Hallel133/Hallel133/docs/img/chair-front.png

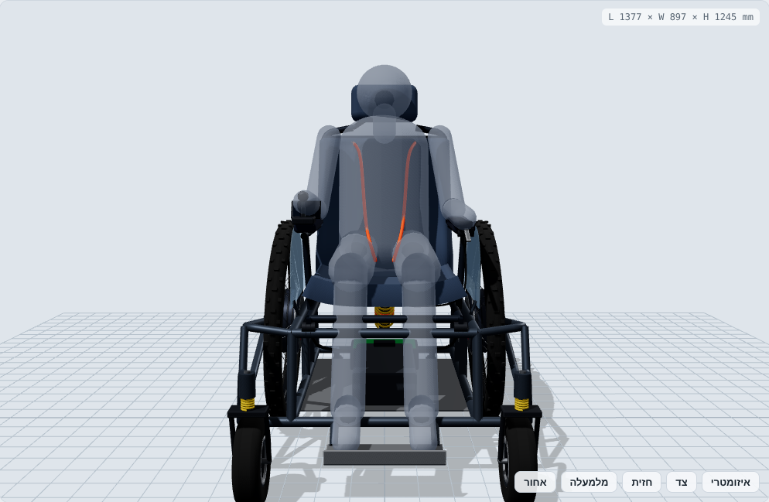
docs/img/chair-front.png
