Hallel133/Hallel133/docs/img/chair-rear.png

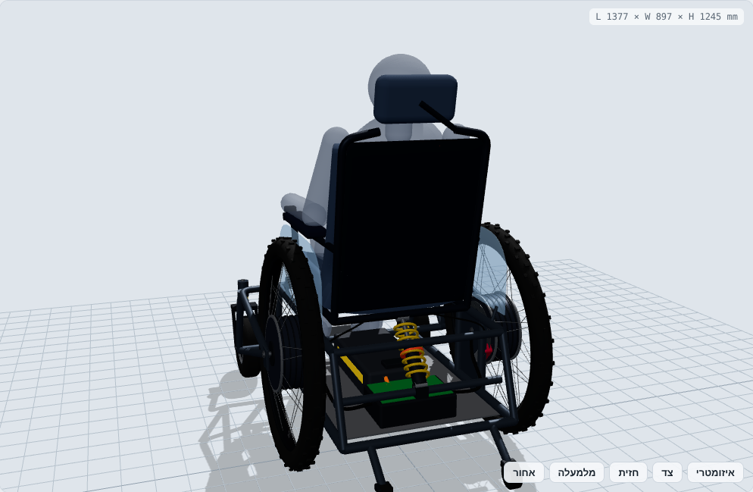
docs/img/chair-rear.png
