Hallel133/Hallel133/docs/img/chair-side.png

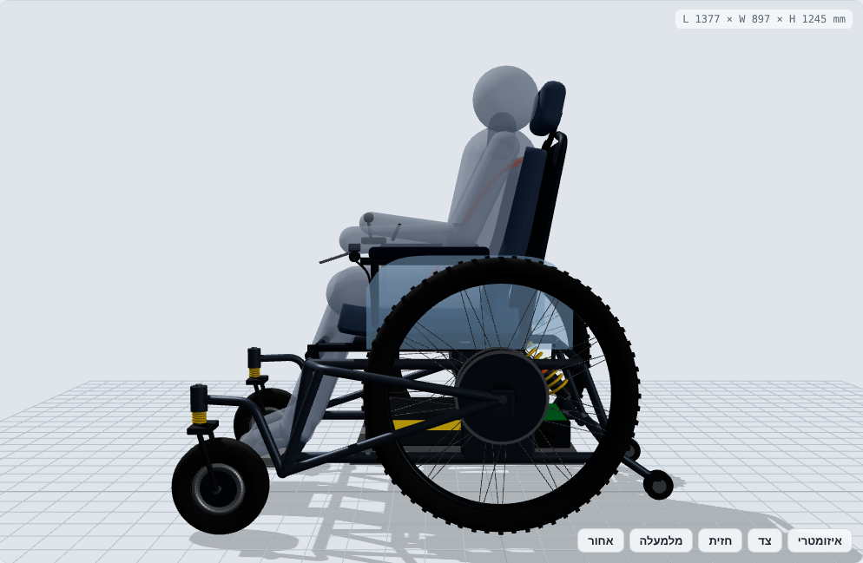
docs/img/chair-side.png
