Hallel133/Hallel133/docs/img/kart-front.png

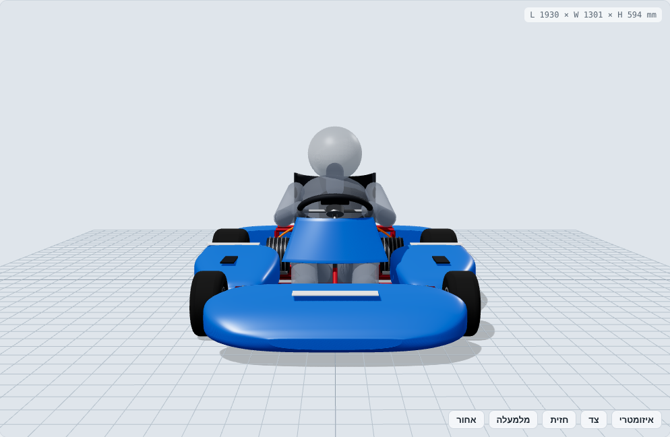
docs/img/kart-front.png
