Hallel133/Hallel133/docs/img/kart-side.png

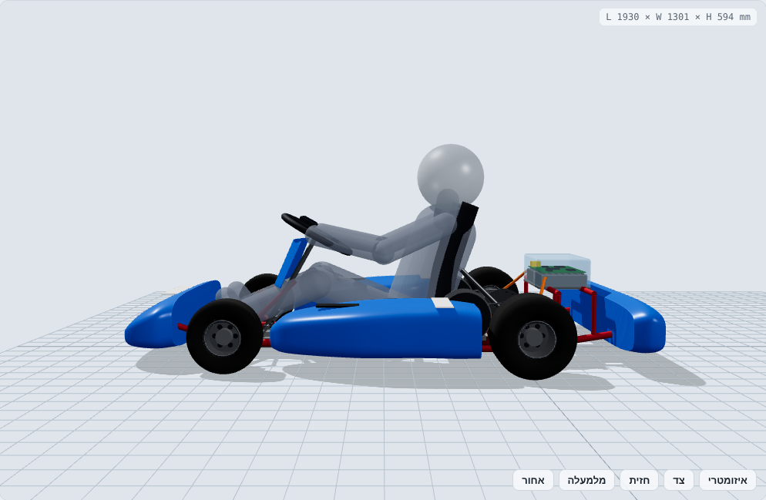
docs/img/kart-side.png
