Hallel133/Hallel133/docs/img/kart-top.png

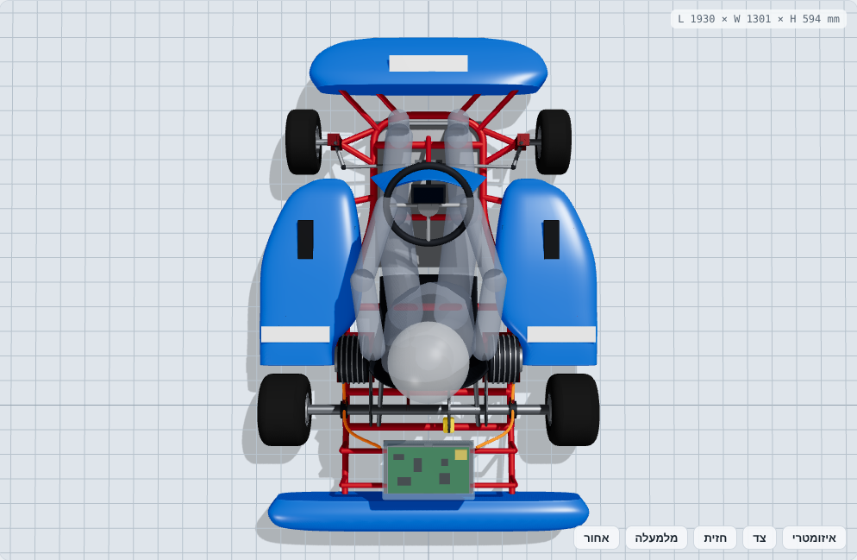
docs/img/kart-top.png
