Hallel133/Hallel133/exports/gokart/chassis.stl

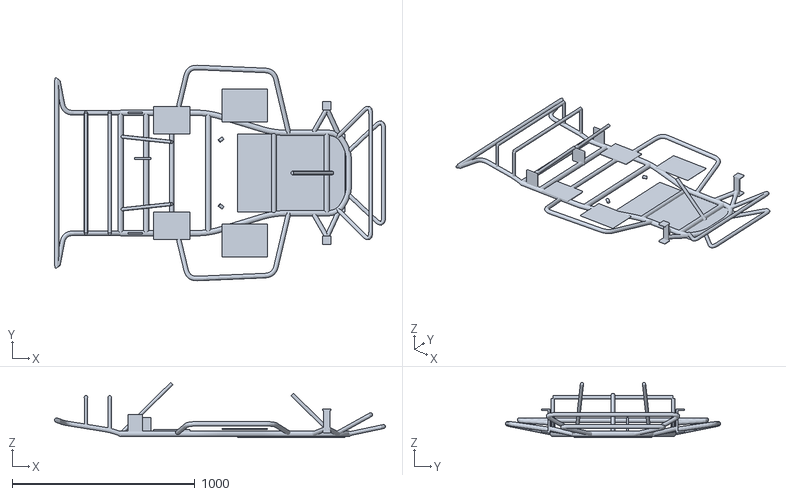
[picture p11: CAD file, 2026-10-14]
exports/gokart/chassis.stl
1813.4 x 1180.7 x 301.4
