Hallel133/Hallel133/exports/wheelchair/seat.stl

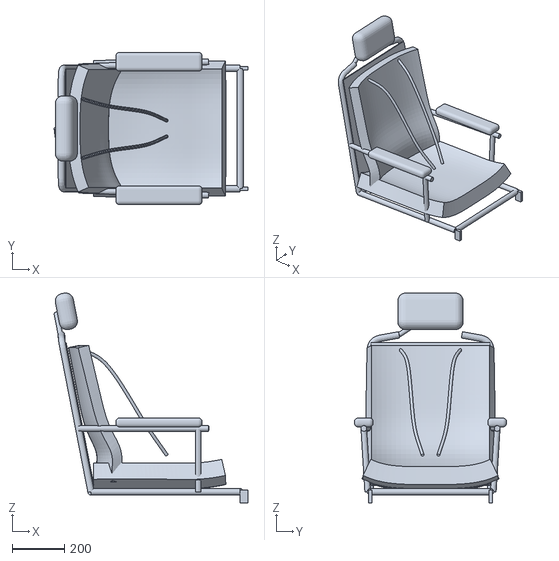
[picture p12: CAD file, 2026-10-14]
exports/wheelchair/seat.stl
741.1 x 582.0 x 803.0
