Hallel133/Hallel133/exports/gokart/battery.stl

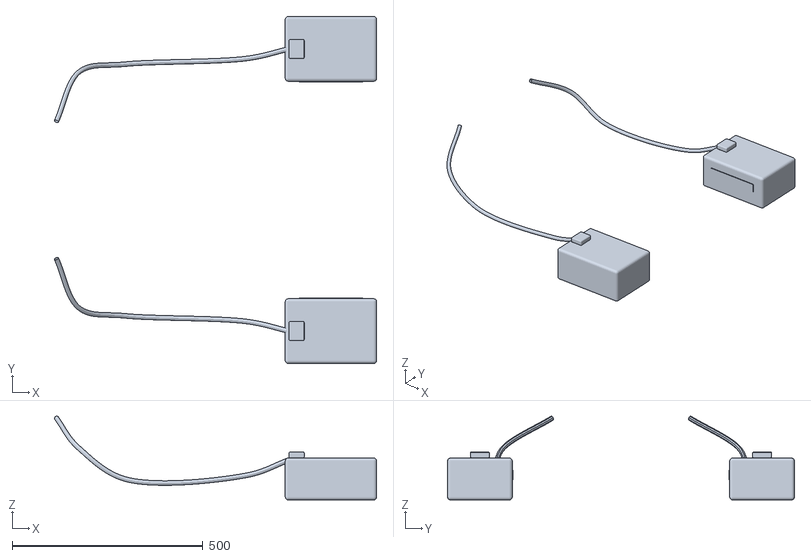
[picture p13: CAD file, 2026-10-14]
exports/gokart/battery.stl
845.6 x 910.0 x 220.1
