Hallel133/Hallel133/exports/wheelchair/frame.stl

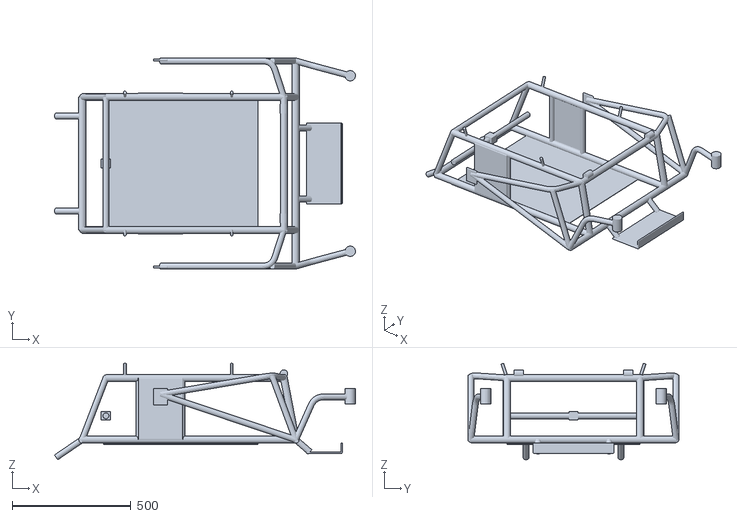
[picture p14: CAD file, 2026-10-14]
exports/wheelchair/frame.stl
1268.9 x 890.0 x 407.0
