Hallel133/Hallel133/exports/gokart/wheels.stl

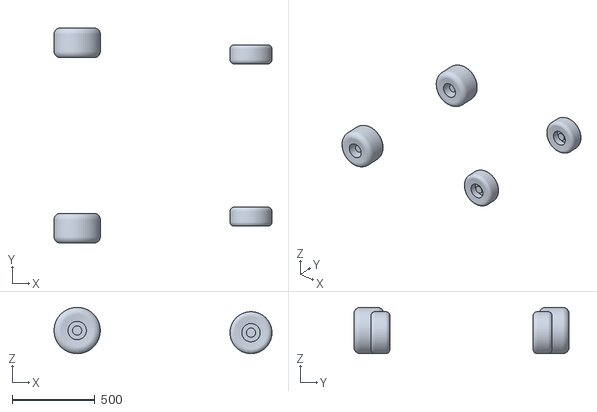
[picture p15: CAD file, 2026-10-14]
exports/gokart/wheels.stl
1317.0 x 1300.0 x 280.0
