Hallel133/Hallel133/exports/wheelchair/wheels29.stl

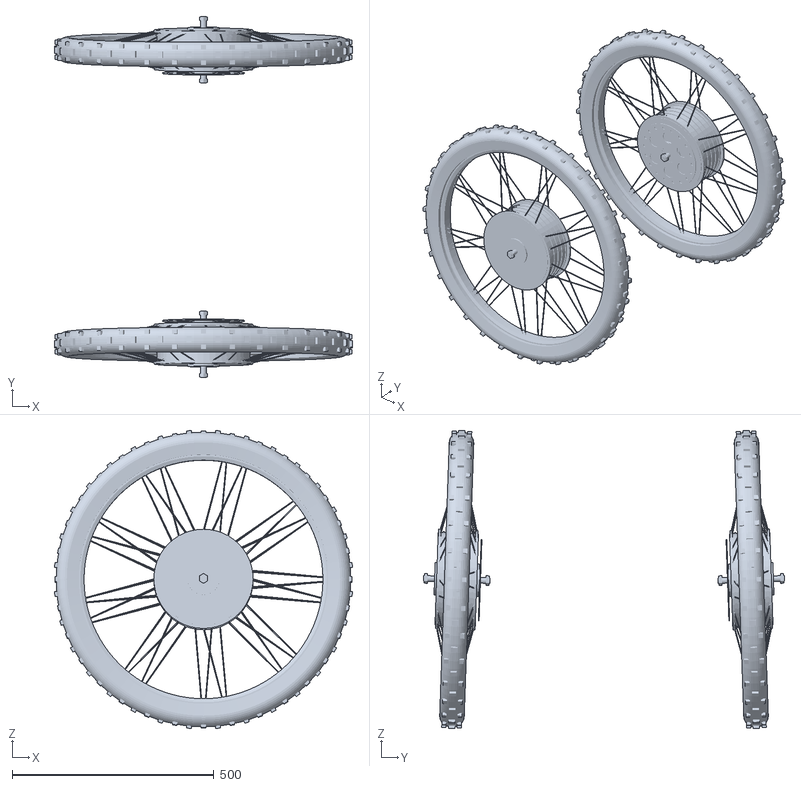
[picture p16: CAD file, 2026-10-14]
exports/wheelchair/wheels29.stl
738.6 x 895.4 x 738.7
