Hallel133/Hallel133/exports/gokart/seat.stl

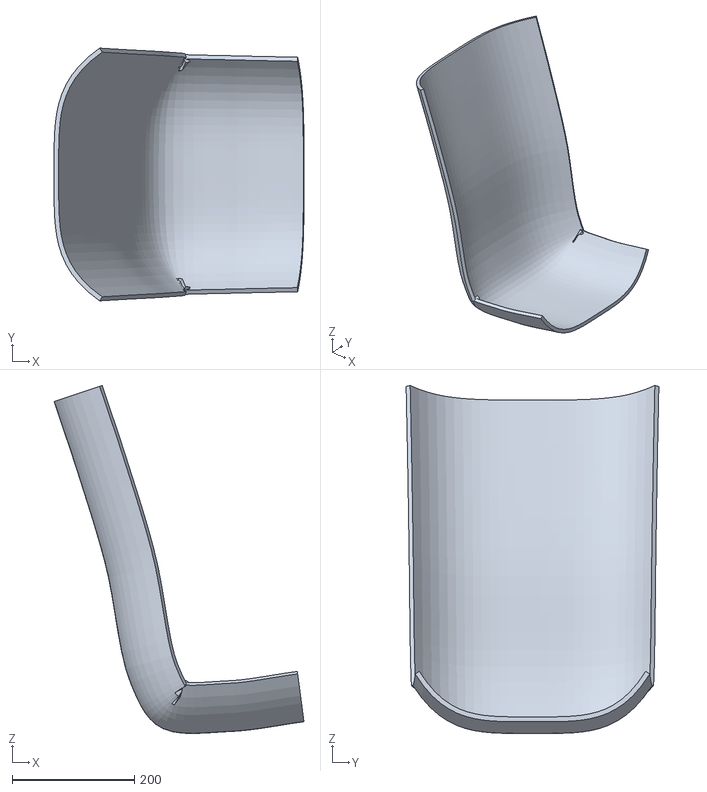
[picture p17: CAD file, 2026-10-14]
exports/gokart/seat.stl
408.7 x 413.3 x 568.9
