Hallel133/Hallel133/exports/wheelchair/brakes.stl

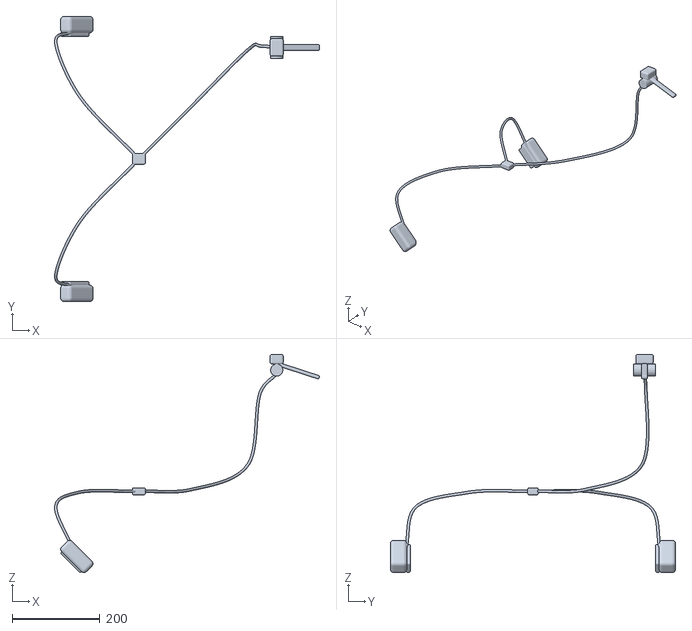
[picture p18: CAD file, 2026-10-14]
exports/wheelchair/brakes.stl
605.6 x 652.0 x 498.9
