Hallel133/Hallel133/exports/gokart/steering.stl

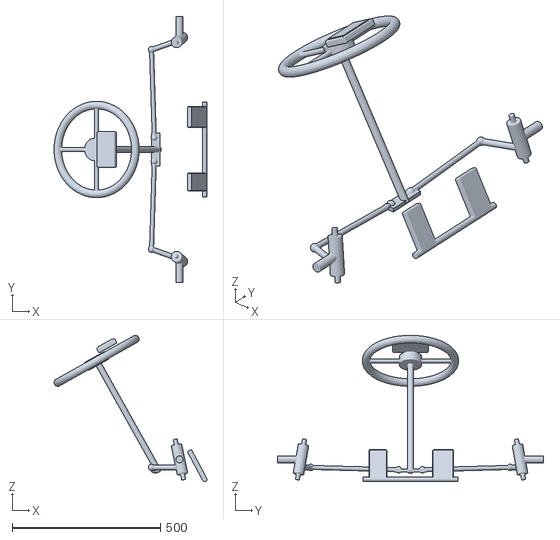
[picture p19: CAD file, 2026-10-14]
exports/gokart/steering.stl
516.9 x 900.0 x 494.1
