Hallel133/Hallel133/exports/wheelchair/electronics.stl

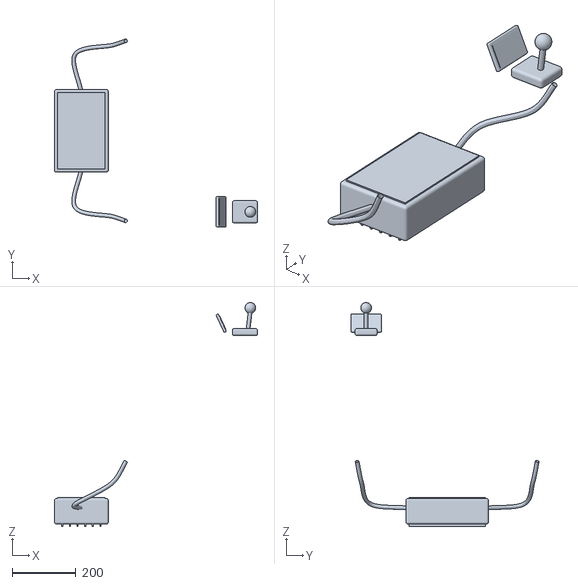
[picture p20: CAD file, 2026-10-14]
exports/wheelchair/electronics.stl
640.0 x 592.4 x 705.0
