Hallel133/Hallel133/exports/gokart/electronics.stl

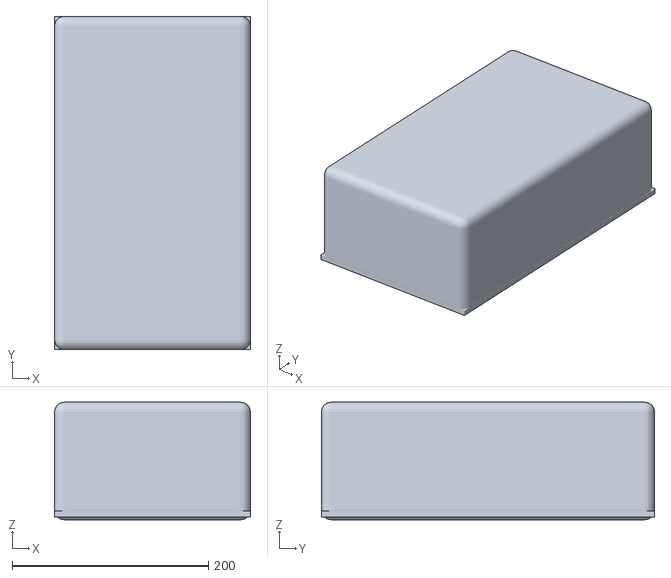
[picture p21: CAD file, 2026-10-14]
exports/gokart/electronics.stl
200.0 x 340.0 x 120.0
