Hallel133/Hallel133/exports/wheelchair/casters.stl

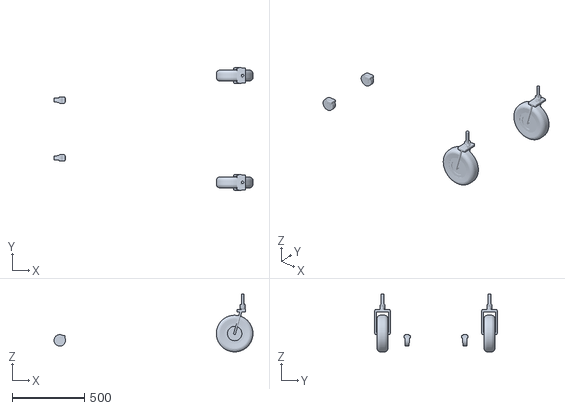
[picture p22: CAD file, 2026-10-14]
exports/wheelchair/casters.stl
1377.0 x 848.9 x 400.0
