Hallel133/Hallel133/exports/gokart/body.stl

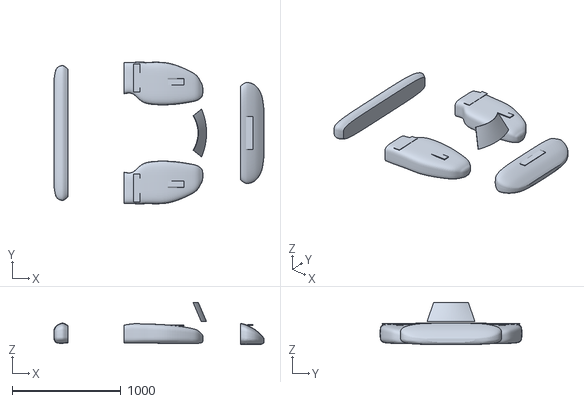
[picture p23: CAD file, 2026-10-14]
exports/gokart/body.stl
1930.0 x 1301.5 x 386.2
