Hallel133/Hallel133/exports/wheelchair/battery.stl

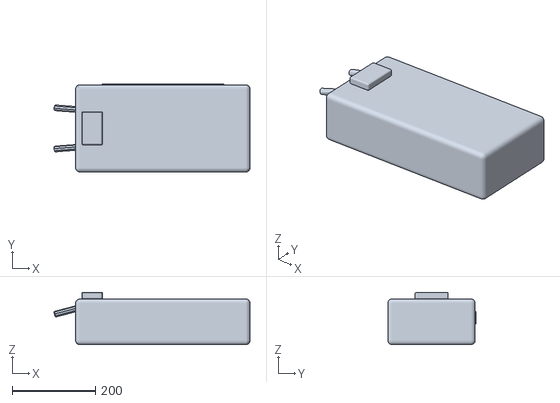
[picture p24: CAD file, 2026-10-14]
exports/wheelchair/battery.stl
472.0 x 212.0 x 126.0
