Hallel133/Hallel133/exports/gokart/drivetrain.stl

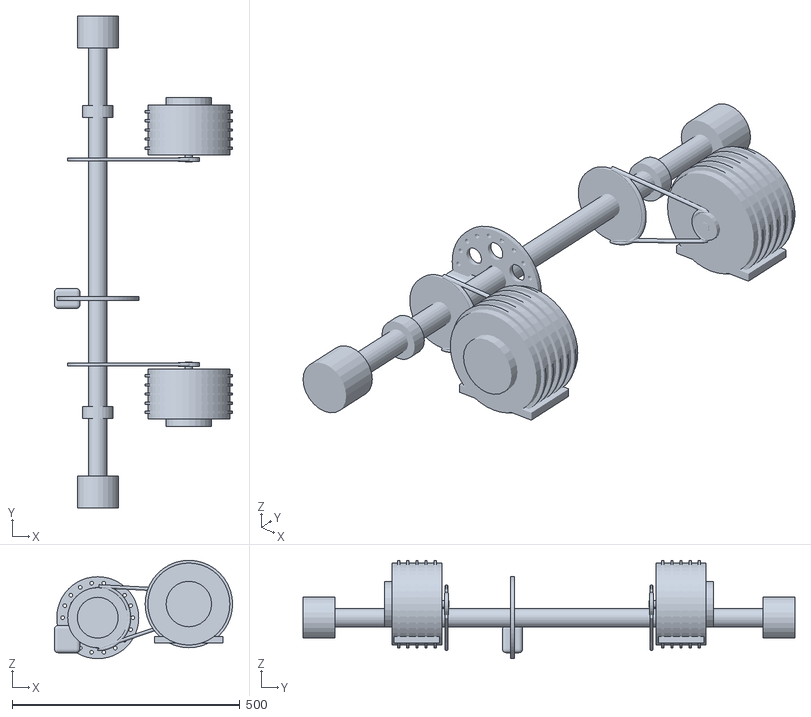
[picture p25: CAD file, 2026-10-14]
exports/gokart/drivetrain.stl
391.2 x 1080.0 x 216.0
