Hallel133/Hallel133/exports/wheelchair/suspension.stl

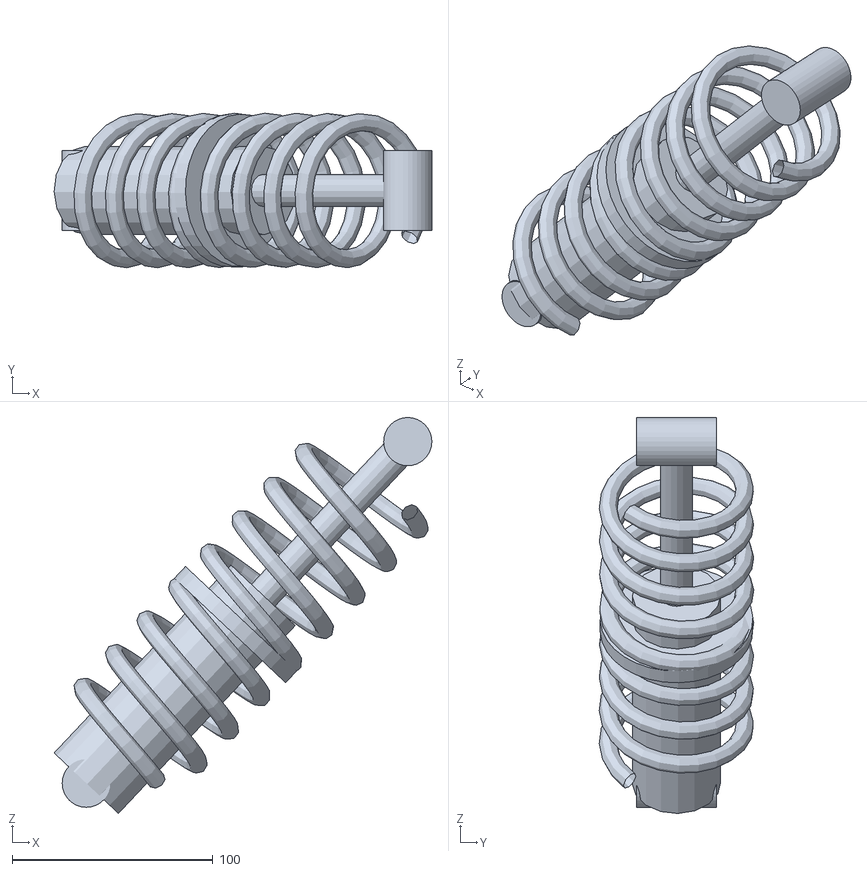
[picture p26: CAD file, 2026-10-14]
exports/wheelchair/suspension.stl
188.0 x 77.0 x 197.1
