Hallel133/Hallel133/exports/wheelchair/guards.stl

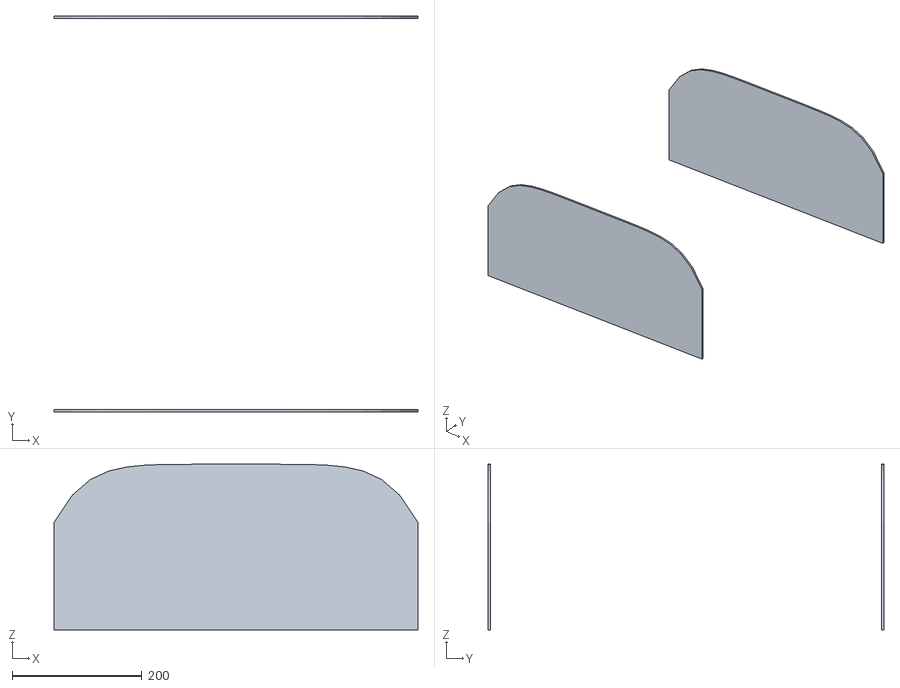
[picture p27: CAD file, 2026-10-14]
exports/wheelchair/guards.stl
560.0 x 610.0 x 255.0
